GmeloG/MesaNiveladora/README.md

# MesaNiveladora
Mesa Niveladora de 3 eixos
