GmeloG/MesaNiveladora/relatorio/Relatorio_LAMEC/front/0_acronyms.tex

% Lista de acrónimos
% No texto: \gls{chave} (1.ª vez escreve por extenso, depois só a sigla)
% Em tabelas, legendas e títulos: \acrshort{chave}
\newacronym{adc}{ADC}{\textit{Analog-to-Digital Converter}}
\newacronym{adrc}{ADRC}{\textit{Active Disturbance Rejection Control}}
\newacronym{ble}{BLE}{\textit{Bluetooth Low Energy}}
\newacronym{bldc}{BLDC}{\textit{Brushless Direct Current}}
\newacronym{ce}{CE}{Conformidade Europeia}
\newacronym{dc}{DC}{\textit{Direct Current}}
\newacronym{edr}{EDR}{\textit{Enhanced Data Rate}}
\newacronym{ekf}{EKF}{\textit{Extended Kalman Filter}}
\newacronym{esc}{ESC}{\textit{Electronic Speed Controller}}
\newacronym{hal}{HAL}{\textit{Hardware Abstraction Layer}}
\newacronym{i2c}{I\textsuperscript{2}C}{\textit{Inter-Integrated Circuit}}
\newacronym{imu}{IMU}{\textit{Inertial Measurement Unit}}
\newacronym{led}{LED}{\textit{Light-Emitting Diode}}
\newacronym{lqg}{LQG}{\textit{Linear Quadratic Gaussian}}
\newacronym{lqr}{LQR}{\textit{Linear Quadratic Regulator}}
\newacronym{mems}{MEMS}{\textit{Micro-Electro-Mechanical Systems}}
\newacronym{mpc}{MPC}{\textit{Model Predictive Control}}
\newacronym{pid}{PID}{controlador proporcional, integral e derivativo}
\newacronym{pwm}{PWM}{\textit{Pulse Width Modulation}}
\newacronym{red}{RED}{\textit{Radio Equipment Directive}}
\newacronym{reee}{REEE}{resíduos de equipamentos elétricos e eletrónicos}
\newacronym{rohs}{RoHS}{\textit{Restriction of Hazardous Substances}}
\newacronym{spi}{SPI}{\textit{Serial Peripheral Interface}}
\newacronym{spp}{SPP}{\textit{Serial Port Profile}}
\newacronym{sram}{SRAM}{\textit{Static Random-Access Memory}}
\newacronym{uart}{UART}{\textit{Universal Asynchronous Receiver-Transmitter}}
\newacronym{ubec}{UBEC}{\textit{Universal Battery Elimination Circuit}}
\newacronym{ue}{UE}{União Europeia}
