GmeloG/MesaNiveladora/relatorio/Relatorio_LAMEC/front/4_frontmatterlists.tex

%----------------------------------------------------------------------------------------
%	FONTMATTER LISTS
%----------------------------------------------------------------------------------------
\pdfbookmark[0]{\contentsname}{toc}
\tableofcontents 	
\glsresetall
%----------------------------------------------------------------------------------------

% Of the following lists, comment the ones you will not use in your document

\listoffigures 			% Prints the list of figures

\listoftables 			% Prints the list of tables

%\printlistoflistings	% Prints the list of listings (source code segments)

%\printlistofalgorithms	% Prints the list of algorithms/pseudo-code

%\printlistofterms		% Prints the list of USED terms (glossary)

\printlistofacronyms{XXXXXXX} % Prints the list of USED acronyms
% Change the argument with random letters to adjust the left alignment of the acronyms full name column

%\printlistofsymbols		% Prints the list of ALL defined symbols
