GmeloG/MesaNiveladora/relatorio/Relatorio_LAMEC/figuras/frente.png

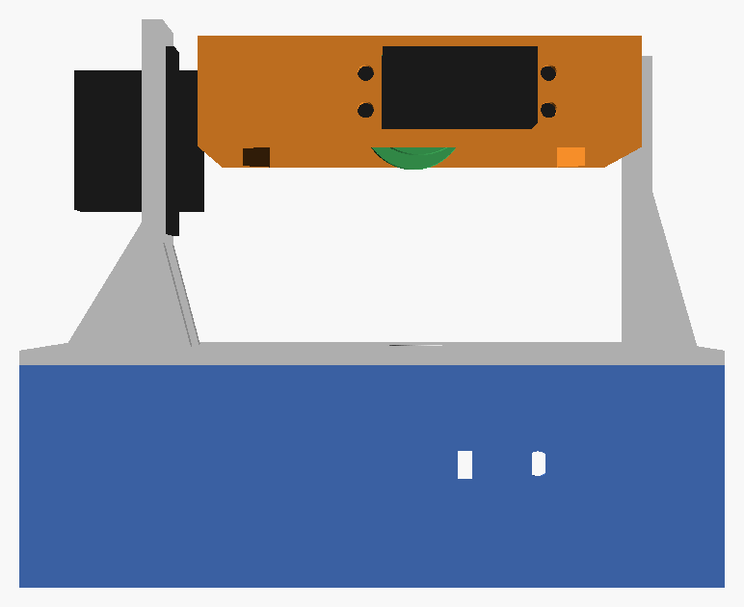
relatorio/Relatorio_LAMEC/figuras/frente.png
