GmeloG/MesaNiveladora/outros/BOM.xlsx

Nome | referencia | Preço | Temos
Nucleo | F767ZI | 0 | Sim
Motores |  |  | Não
