GmeloG/MesaNiveladora/Modulo3D/tabuleiro.stl

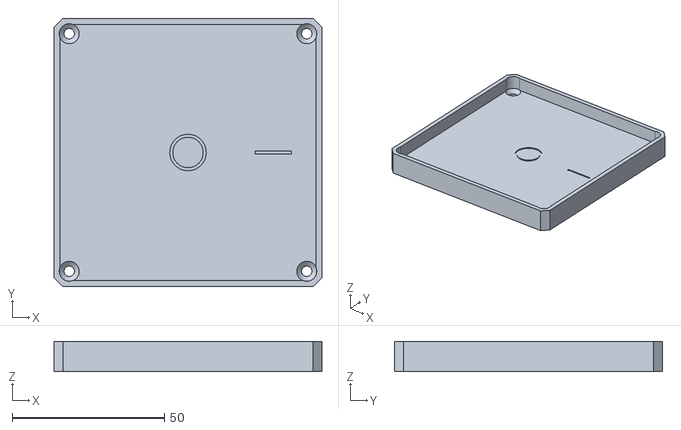
[picture p23: CAD file, 2026-11-12]
Modulo3D/tabuleiro.stl
88.0 x 88.0 x 10.0
