GmeloG/MesaNiveladora/Modulo3D/tampa.stl

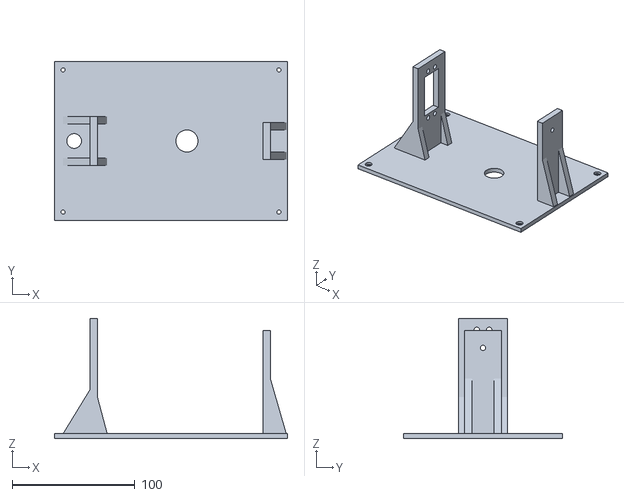
[picture p24: CAD file, 2026-11-09]
Modulo3D/tampa.stl
190.0 x 130.0 x 98.0
