GmeloG/MesaNiveladora/Modulo3D/caixa.stl

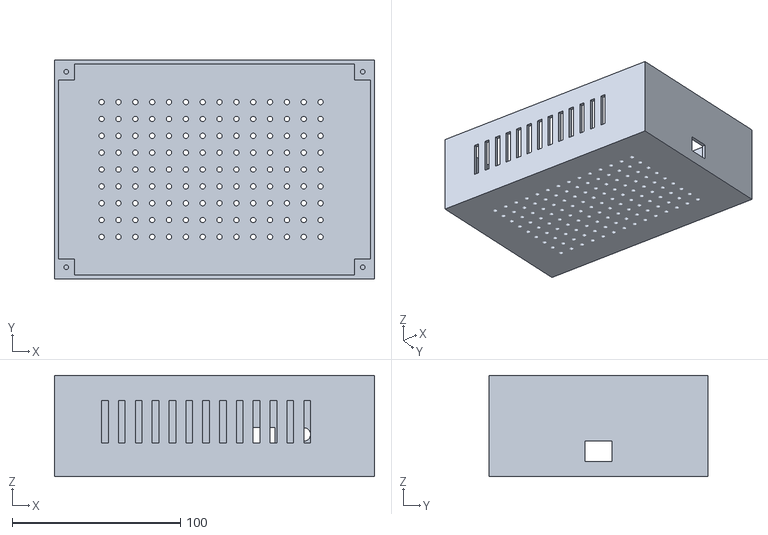
[picture p25: CAD file, 2026-11-09]
Modulo3D/caixa.stl
190.0 x 130.0 x 60.0
