GmeloG/MesaNiveladora/Modulo3D/plataforma.stl

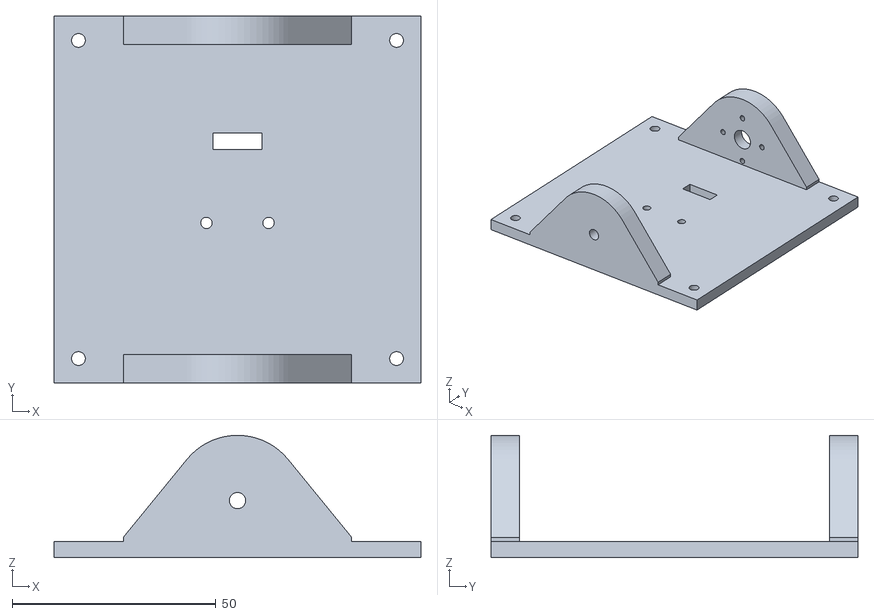
[picture p26: CAD file, 2026-11-09]
Modulo3D/plataforma.stl
90.0 x 90.0 x 30.0
