GmeloG/MesaNiveladora/Modulo3D/quadro.stl

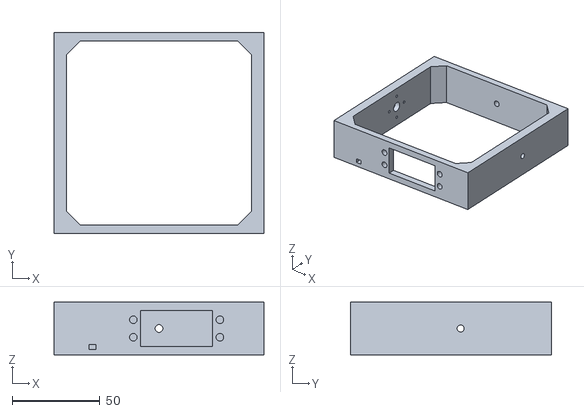
[picture p27: CAD file, 2026-11-09]
Modulo3D/quadro.stl
120.0 x 115.0 x 30.0
