GmeloG/MesaNiveladora/(commit log)

2026-10-19 Add initial project files and implement MPU6050 driver with complementary filter
2026-11-09 feat: Update platform and framework for STM32duino; add main application
    - Updated platform to ststm32@19.7.1 and framework to Arduino (4.21200.0).
    - Added main application for IMU, PID control, and servos.
    - Introduced new tests for Bluetooth echo and sensor integration.
    - Implemented PID control structure for servo management.
    - Enhanced serial communication for debugging and telemetry.
    - Added CPU flags script to address compilation issues with Cortex-M7.
    - Created a diagnostic test for basic functionality and USB communication.
    [blink_test.cpp, bt_echo.cpp, imu.h, imu_test.cpp, main.cpp, pid.h]
2026-11-09 Add main table of contents, preamble, and references for Relatorio LAMEC
    - Created main.toc file with structured table of contents including chapters and sections.
    - Added preamble.tex with necessary packages and settings for the document.
    - Introduced referencias.bib containing a comprehensive list of references used in the report.
    [BOM.xlsx, caixa.stl, plataforma.stl, plataforma_2eixos.scad, quadro.stl, tampa.stl]
2026-11-11 fix: Improve Bluetooth device connection handling and error logging in index.html
2026-11-12 Add peca_tabuleiro.png image to Relatorio_LAMEC figures directory
    [plataforma_2eixos.scad, tabuleiro.stl]
